sinara-hw/Stabilizer_Piezo_Driver/README.md

# Stabilizer_Piezo_Driver
Simple piezo driver mezzanine for Stabilizer

## Design Files

Design files (schematics, PCB layouts, BOMs) can be found at [Stabilizer_Piezo_Driver/Releases](https://github.com/sinara-hw/Stabilizer_Piezo_Driver/releases).

## Wiki

More information can be found on the [wiki](https://github.com/sinara-hw/Stabilizer_Piezo_Driver/wiki).
