sinara-hw/Stabilizer_Piezo_Driver/(list of files, drawings)

Other design files:
pcb/HV_DRV_ADHV4702.SchDoc
pcb/HV_DRV_PA15FLA.SchDoc
pcb/mechanics.SchDoc
pcb/Offset_Selector.SchDoc
pcb/overtemp_indicator.SchDoc
pcb/power_supplies.SchDoc
pcb/Stabilizer_Piezo_Driver.PrjPCB
pcb/Stabilizer_Piezo_Driver.SchDoc
