sinara-hw/Stabilizer_Piezo_Driver/(threads)

Thread 1 (2019-05-16):

[RFC] New daughterboard: Piezo Driver

dtcallcock, 2019-05-16:
I am thinking that many Stabilizers will end up servoeing on piezos (doubling cavities, laser cavities, mirror adjusters etc.).  Therefore does it make sense to have a dedicated daughterboard for this?

Obviously [Zapper](https://github.com/sinara-hw/zapper/issues/1) is under development but may end up being overkill for this application.  I'm imagining a very simple board with a DC-DC module, a couple of HV opamps and a few DIP switches to set ranges.

Closed 2019-12-01.

Thread 2 (2019-09-07):

ADHV4702

dtcallcock, 2019-09-07:
I may need to get something working before this board is ready so I'm planning on ordering an [eval board](https://www.analog.com/media/en/technical-documentation/user-guides/EVAL-ADHV4702-1CPZ-UG-1444.pdf) for the new [ADHV4702](https://www.analog.com/media/en/technical-documentation/data-sheets/ADHV4702-1.pdf).

If that works out I'll let you know.  Perhaps we could just copy this design (and make it 2-ch) if it does.

gkasprow, 2019-12-01:
@dtcallcock any opinion here?
I'd like to finish the design. Anyway, I implemented bot ADHV4702 + my discrete driver.

hartytp, 2019-12-01:
Cool. Do you have a schematic preview? I won't have time to do a design review, but I'm just curious...

gkasprow, 2019-12-01:
@hartytp  Here are very initial, not finished schematics
[stabilizer_current_sense.PDF](https://github.com/sinara-hw/Stabilizer_Piezo_Driver/files/3908742/stabilizer_current_sense.PDF)

dtcallcock, 2020-01-05:
> I implemented bot ADHV4702 + my discrete driver.

What do you think your driver will offer over the ADHV4702?

Will the two options be population options or will there be a switch or jumper?

dtcallcock, 2020-01-05:
Is it worth running anything to the GPIO header?  Perhaps just the status LEDs so that Stabilizer can throw an error if the amp shuts down?

gkasprow, 2020-01-05:
I implemented this discrete driver mainly for fun. We will probably leave only ADHV chip.
My driver can easily go +/- 60V into the 1nF load at 1MHz and can be easily scaled by changing the MOSFETs. Driver can be selected by the jumpers.

Thread 3 (2019-09-07):

Form Factor

dtcallcock, 2019-09-07:
Whilst a stabilizer AFE would be the most convenient in some circumstances it would preclude use with [Pounder](https://github.com/sinara-hw/Pounder/issues) or [Driver](https://github.com/sinara-hw/meta/issues/37) if they end up being Stabilizer AFEs.

How about just making it a standalone board with 2x input/output on the FP and barrel connectors for power?

We could make the board-board connectors a population option to retain AFE capability.

hartytp, 2019-09-07:
How would you configure it?

hartytp, 2019-09-07:
Or, is this just a 2 channel, fixed-gain (DIP switches?) HV amp?

dtcallcock, 2019-09-07:
Yeah, this board would be super-simple.  If you want bells and whistles there will be Zapper at some point.

DIP switches to select between a few different ranges and gains would be useful if easy to implement.

hartytp, 2019-09-07:
What use cases are you thinking of for this, and where would the D/A be?

dtcallcock, 2019-09-07:
> What use cases are you thinking of for this

My idea is to have the simplest possible board that would allow Stabilizer to drive piezos.  The only reason not to make it specifically a Stabilizer AFE is that it would block you from using other AFEs.

> , and where would the D/A be?

This would just be a completely analog voltage amplifier.

hartytp, 2019-09-07:
> This would just be a completely analog voltage amplifier.

I meant what would drive it, but you answered that anyway.

> My idea is to have the simplest possible board that would allow Stabilizer to drive piezos. The only reason not to make it specifically a Stabilizer AFE is that it would block you from using other AFEs.

hmmm. Are you saying that you would use the same Stabilizer card to drive Zapper that you also use with another AFE?

dtcallcock, 2019-09-07:
> hmmm. Are you saying that you would use the same Stabilizer card to drive Zapper that you also use with another AFE?

Yes.  For example, for a doubling cavity lock (or locking a fiber laser to an iodine reference cell) you would have a PDH AFE on Stabilizer and then this piezo driver board between Stabilizer and the cavity piezo.

> drive Zapper

This isn't [Zapper](https://github.com/sinara-hw/zapper/issues/1).  Right now Zapper looks like it will be [way overspecced](https://github.com/sinara-hw/zapper/issues/1#issuecomment-497932589) for this common use case.  Obviously the Zapper spec is not set in stone yet though.

Perhaps the name of this repository should be changed to 'Stabilizer piezo driver' or something.

hartytp, 2019-09-07:
> Yes. For example, for a doubling cavity lock (or locking a fiber laser to an iodine reference cell) you would have a PDH AFE on Stabilizer and then this piezo driver board between Stabilizer and the cavity piezo.

Okay, makes sense. So this allows you to cover that case with only a single stabilizer. Fair enough.

gkasprow, 2019-09-20:
Let's draft specification:
- 3U form factor with panel, board size identical to current sense mezzanine.
- 2 HV channels
- ADHV4702 + my [discrete component driver](https://github.com/sinara-hw/Stabilizer_Piezo_Driver/issues/1#issuecomment-505290412) + DIP switch for configurable gain. This would let us test things for Zapper.
- 2x SMA input (maybe MCX?)
- 2x SMA output
- DC jack + 4 pin Molex supply connector on the back
- optional pin header for direct attach to the Stabilizer as a mezzanine
- 2x DC/DC converter [ R12-100B](https://www.digikey.com/en/datasheets/recom-power/recom-power-rxx-b) which can be adjusted +50...+135. We can make it adjustable by DIPswitches and simple protection circuit which makes sure we never exceed ADHV4702 safe operation range of 220V. Do we need to support asymetrical operation?

gkasprow, 2019-09-20:
do we plan to add some current limit protection for the ADHV4702 ?
It has internal temperature sensor. It could be used to disable power and turn on big, red LED on the front panel. The chip has also temperature protection that needs to be enabled.

dtcallcock, 2019-09-20:
> 2x SMA input (maybe MCX?)

Probably makes sense to use SMA so that a short SMA jumper can be used.

> 2x SMA output

Often slightly less common connectors are used on HV supplies to prevent accidentaly connecting the wrong thing and destroying it. I have seen SMB, SMC, LEMO OO and LEMO 0B used.

> DC jack + 4 pin Molex supply connector on the back

The DC jack would be on the front?  If so, would you be able to use a short barrel-barrel cable to power it from a Stabilizer running on POE?

> DC/DC converter R12-100B which can be adjusted +50...+135

150 and 200V piezos are also out there.  I think +135V is close enough to 150V and 200V piezos are uncommon enough that this is acceptable.  However if there is a different DC/DC that will do 50-150V  or 50-200V that would be better.

Otherwise looks great.

dtcallcock, 2019-09-20:
> do we plan to add some current limit protection for the ADHV4702 ?
It has internal temperature sensor. It could be used to disable power and turn on big, red LED on the front panel.

That seems to be how the datasheet is recommending you implement short circuit protection.  Sounds reasonable to me.

gkasprow, 2019-09-20:
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

LEMOs are expensive. They are woth their price, but still. SMB/SMC is fine

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

Yes, but there is also 12V on the mezzanine connector

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

Thre is compatible R12-150B that goes +92...+200.
So, the question is if we should make it to support asymmetrical operation.
For example, the user can select let's say +150, -50V. Then shall we add some adjustable offset to the input or simply sacrify the DAC resolution ?
>
> Otherwise looks great.

gkasprow, 2019-09-20:
The evaluation kit of [ADHV ](https://www.analog.com/media/en/technical-documentation/user-guides/EVAL-ADHV4702-1CPZ-UG-1444.pdf)chip has on-board DC/DC converter based on [LT8304 ](https://www.analog.com/media/en/technical-documentation/data-sheets/8304fa.pdf). We can copy the design and make it operational over wider voltage range than R12-xxxB modules.

gkasprow, 2019-09-20:
Such solution can generate symetrical outputs. But I'm not sure if it is worth the effort.  The Recom modules are not that expensive (38EUR/pc)

dtcallcock, 2019-09-23:
>So, the question is if we should make it to support asymmetrical operation.

I've never had a need for piezo drivers that goes negative.

hartytp, 2020-01-08:
Was a decision made on the form-factor for this? IIRC it was decided (and I think it's a good idea) to make this a stand-alone card with a FP power connector, rather than a stabilizer mezzanine. Is that correct/still the case?

If so, this project should have a name change really. Also, what's the differentiation between this and the Zapper proposal? Just that Zapper is bipolar? Or, should they be merged?

hartytp, 2020-01-08:
@dtcallcock out of curiosity, what are your plans for using this for OSAs? What will you do for the transimpedance front-end for the PD? Will you design a small PCB to go right by the cavity? If so, how do you plan to power it? Use an external supply or break out the Stabilizer supplies somehow? Just curious...

gkasprow, 2020-01-08:
This module can either work as a Stabilizer mezzanine or stand-alone 2-channel amplifier.
This design is a 2-channel amplifier while Zapper will be multi-channel EEM.

hartytp, 2020-01-08:
> This module can either work as a Stabilizer mezzanine or stand-alone 2-channel amplifier.

Okay, nice :)

> This design is a 2-channel amplifier while Zapper will be multi-channel EEM.

I see. How many channels will Zapper have?

hartytp, 2020-01-08:
Answering my own question: [8](https://github.com/sinara-hw/zapper/issues/1)

How realistic is that from a power/component density point of view.

Anyway, I guess that there are enough differences between the two designs that it doesn't make sense to try to unify them.

gkasprow, 2020-01-08:
I treat the Piezo Driver as a prototype of Zapper. We will test PSU, 2 amplifier conceptions, protections.
If we go for ADHV4702, we can have even 32 channels. Some limitation is the output connector which needs to work with HV. There are [industrial rectangular connectors](https://www.tme.eu/html/EN/hi-temp-connector-inserts-180-degc/ramka_13219_EN_pelny.html) that can handle such voltage.

dnadlinger, 2020-01-08:
Not wanting to derail this discussion here, but for open-loop applications, charge-based drive might also be interesting to improve linearity/reduce hysteresis. (One use in AMO labs would be e.g. for multi-axis positioners/mirror mounts, although predictable response matters less there than for microscopy or trying to make absolute changes to lens positions in an imaging system.)

dtcallcock, 2020-01-08:
> @dtcallcock out of curiosity, what are your plans for using this for OSAs? What will you do for the transimpedance front-end for the PD? Will you design a small PCB to go right by the cavity?

Yes.  Perhaps Nadlinger's board.  Perhaps just an eval board.

> If so, how do you plan to power it? Use an external supply or break out the Stabilizer supplies somehow?

There was talk of putting some kind of power connectors (eg. M8-3) on here (or Stabilizer/Pounder), but there doesn't seem to be the front panel space for it.  For now I'll probably go with a bench PSU.  I have been thinking it might be worth developing a Eurocard PSU for Sinara though.

> I guess that there are enough differences between the two designs

There was an idea that Zapper would have onboard DACs and and EEM interface too.  Obviously the spec is still up for grabs.

> If we go for ADHV4702

A range of >200V was envisaged but if the ADHV4702 works great we should revisit that requirement.

gkasprow, 2020-01-08:
Btw, the 3U PSU is under development. One can see some drawings [here](https://viewer.autodesk.com/id/dXJuOmFkc2sub2JqZWN0czpvcy5vYmplY3Q6YTM2MHZpZXdlci90NjM3MTMyMTY5NDI3NjA3MzM4X2E5YjQzMDEzLTg4ZWQtNGVhZC05ZTM4LWUzODFlNzcyYWUyNy5jb2xsYW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)
It is cooperation with CERN, we develop a low-cost alternative to COTS solutions.
One is 230V, 400W
Another is 18-72V, 200 or 400W. They fully conform with CPCIS including ORing and current sharing. The AC version has an IEC connector on the front panel. It also supports power delivery via a backplane connector. There is an option to produce it without any active circuits, just 12V.
We can make a version with just DC jacks on the front panel and Molex connectors on the back panel if there is enough interest.

dnadlinger, 2020-01-08:
> If so, how do you plan to power it? Use an external supply or break out the Stabilizer supplies somehow?

One option would be to settle on a common "sensor" connector for the ecosystem (e.g. photodiodes, external preamps, …). We could just use a 4-pin LEMO connector and two twisted pairs (+12/power ground, signal/signal ground) if we are careful with conducted EMI from the DC/DC converters we'd invariably need on the peripherals.

gkasprow, 2020-01-08:
About the standardized connectors, LEMOs are great but expensive. Would 4 pins be sufficient? What about M8? They are low cost, robust and support up to 8 pins.

gkasprow, 2020-01-08:
@dnadlinger Do you mean HV amplifier with the current output? Let's start a discussion about it in /meta

hartytp, 2020-01-08:
https://www.piezodrive.com/wp-content/uploads/2016/01/IntroToCharge.pdf

gkasprow, 2020-01-08:
We could try to implement it as a feature of the Piezo Driver, but we would need other connectors. Moreover, I think such a driver needs to be matched with piezo to maintain stability.

hartytp, 2020-01-08:
> There was an idea that Zapper would have onboard DACs and and EEM interface too. Obviously the spec is still up for grabs.

If the DACs were really the only difference I'd have thought it would make sense to unify the design. The cost of adding a couple of SPI DACs and an EEM connector to this design is basically nill.

However, it sounds like there are more differences than that, so the designs should remain separate. I don't feel strongly either way, just interested to understand the design goals.

hartytp, 2020-01-08:
> One option would be to settle on a common "sensor" connector for the ecosystem (e.g. photodiodes, external preamps, …). We could just use a 4-pin LEMO connector and two twisted pairs (+12/power ground, signal/signal ground) if we are careful with conducted EMI from the DC/DC converters we'd invariably need on the peripherals.

:+1:

Thread 4 (2019-12-01):

Power supply

gkasprow, 2019-12-01:
I plan to make the design quite universal. What about using 2 power supplies, each delivering 50..135V or 92..200V depending on assembly variant.
Then the user can choose the voltage range, both positive and negative by toggling the two rotary switches. One of 4 values would be possible within tuning range of each power supply.
In this way, any combination of upper and lower rails would be possible
So one can have for example
- 0-200 (one DC/DC module only)
-50..+50
-100..+100
-200..0 (one DC/DC module only)
-75..+75, etc.
-50...+150
There is simple protection circuit that checks if the Vpos - Vmin <200V. If it's true then power is disabled and an alarm LED is lit.
The rail voltages are signalized using 8 LEDs on the front panel.
In addition, an offset can be added to the input amplifier to use the DAC range fully. 16-position hex rotary swich would do the job.
Maybe one DIP switch to choose the gain.
In this way, we can satisfy most use cases by just adding a few resistors and 3 switches.
The module can operate stand-alone supplied from a single 12V DC jack or 4 pins Molex connector.
It can be also supplied from Stabilizer where DAC outputs are routed to the inputs.

gkasprow, 2019-12-01:
Edit: to simplify the design, the switches can be placed on the panel. No LEDs are needed.
The only LEDs woult be PowerOK and Overvoltage alert
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

dtcallcock, 2020-01-05:
> 50..135V or 92..200V depending on assembly variant

How about using something that can do 0-200V to avoid having variants:

https://www.xppower.com/portals/0/pdfs/SF_C_Series.pdf
https://www.xppower.com/portals/0/pdfs/SF_CA_Series.pdf

These are ~$150 compared to the ~$50 of the Recom module but if there is only one (see below) and population options are avoided, then that seems reasonable.  They look like they are lower EMI/ripple too.

> both positive and negative

I'd be happy to drop the negative voltages.  This simplifies the design as the offset is fixed and the gain and output voltage can just be controlled by the same single dial.  The overvoltage detection circuit can also be omitted.

Does anyone have a use case for negative voltages?

jbqubit, 2020-01-06:
Piezo response becomes highly nonlinear < -20  V. There's no practical application I can see for a negative rail below -20 V. See Newport [tech note](https://www.newport.com/medias/sys_master/images/images/hf1/hc8/9046758588446/Tech-Note-Piezo-Theory-Physics-and-Design.pdf).

dtcallcock, 2020-01-06:
>There's no practical application

There are exotic piezo stacks like [tube scanners](https://www.piezodrive.com/actuators/piezoelectric-tube-scanners/) that require symmetric +/-V.  I've never seen one used in an AMO lab and given the number of commercial solutions out there I think the emphasis for this board should be simplicity rather than covering all possible uses.

>negative rail below -20 V

I note that some commercial piezo drivers go slightly (eg. 10-20V) negative, but most do not.  I don't think this is a feature worth increasing circuit complexity for (or necessarily even desirable).

jbqubit, 2020-01-06:
Suppose a piezo with 100 V max rating. I can think of two aspects in favor of -20V. 1) 20% increase in travel 2) 20% lower peak voltage for a given travel (lower stress may increase piezo lifetime). I've certainly encountered circumstances where that 20% increase in scan range made my life much easier.

I don't feel strongly about it.

gkasprow, 2020-01-06:
The amplifier is not rail-to-rail type. It needs a certain negative supply to support operation from 0.

dtcallcock, 2020-01-07:
The ADHV4702 can get within 1.5V of the rail.  Can we run V_EE off the planned -5V rail?

gkasprow, 2020-01-07:
Yes, we can and we should.

JakubKajzer, 2020-08-03:
Hello
I have a few questions about the power supply:
1. Should we keep 50..135V/92..200V  high voltage supply variants or "using something that can do 0-200V to avoid having variants"?
2. Just to be sure, only negative voltage we need is -5V?

Thread 5 (2020-11-06):

schematic review

gkasprow, 2020-11-06:
@JakubKajzer
- the amplifier gain depends on the source output impedance. did you take it into account?
- connecting outputs of two amplifiers is not a good idea.
- did you simulate the signal chain with offsets?
- if you need components that are missing in the libs, let me know
- why R21 is 47Ohm?
- it would be good to add some signalization of overtemperature. Are you sure that the connection between TMP and SD is a good idea?
- the idea behind the latch-up circuit was to protect the amplifier before too high a voltage, not temperature.
- what is the role of IC10?
- do you think the 5V rail has low noise and stability so can be injected to the OFFSET input?
- will OPA197 work with output close to rails under the load?

JakubKajzer, 2020-11-27:
>the amplifier gain depends on the source output impedance. did you take it into account?

Yes, I simulated an amplifier with various capacitance at output. At lower gain, this problem is more visible, but due to significant series resistance at the output, the max gain peak is about 3dB at about 300kHz

>connecting outputs of two amplifiers is not a good idea.

Sorry for that, my mistake. It is a good idea, to make an optomos switch at outputs instead of switching inputs?

>did you simulate the signal chain with offsets?

Yes, offset is amplified with the same gain as an input signal.
In a discrete driver, the gain is 100x, so the offset can easily saturate the driver. Should I lower the gain?

>why R21 is 47Ohm?

I don't know what capacitances will be driven, so I decided to choose 47Ohm. This value should be less when driving bigger capacitances and should be higher when driving smaller capacitances (according to a datasheet of ADHV4702-1).

>it would be good to add some signalization of overtemperature. Are you sure that the connection between TMP and SD is a good idea?

A red led on the front panel will be enough? Connecting TMP and SD together, according to the datasheet, provides overtemperature protection.

>the idea behind the latch-up circuit was to protect the amplifier before too high a voltage, not temperature.

I added overtemperature protection because there wasn't any for the discrete driver. Should I add overvoltage protection?

>what is the role of IC10?

I added IC10 to negate LM75 outputs, so LM75 could work without changing its internal registers.

>do you think the 5V rail has low noise and stability so can be injected to the OFFSET input

Now I see that I should add a pi filter to offsets supply.

>will OPA197 work with output close to rails under the load?

OPA197 can provide about 2mA at the output with a 0.1V swing from the power supply.

gkasprow, 2020-12-16:
> >the amplifier gain depends on the source output impedance. did you take it into account?
>
> Yes, I simulated an amplifier with various capacitance at output. At lower gain, this problem is more visible, but due to significant series resistance at the output, the max gain peak is about 3dB at about 300kHz

I meant SOURCE impedance, not the impedance of the amplifier

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

you need to switch both.
Just use DIP switches to choose which one is connected to input and output. Make sure both cannot be selected

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

yes, use full DAC range

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

OK, make it big, 0805 or so

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

OK, use red LED.

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

If there is a risk that the user can setup dangerous voltage for driver IC, add such protection.

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

since we don't need such circuit for temperature protection, skip it.

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

please add low noise LDO

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

OK
>
>
>

JakubKajzer, 2021-01-01:
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

I checked this at simulation and due to low input impedance, at input must be placed a voltage follower like in discrete amplifier.

gkasprow, 2021-01-13:
sure, you can increase the supply to +/-12V. It is already available from Stabilizer.
Yes, change the MOSFET, but use one with similar specs as the low-side one.

JakubKajzer, 2021-01-20:
I've uploaded updated schematics.

dtcallcock, 2021-03-05:
@JakubKajzer Can you post a pdf please?

JakubKajzer, 2021-03-06:
@dtcallcock
Of course
[schematic.PDF](https://github.com/sinara-hw/Stabilizer_Piezo_Driver/files/6096184/schematic.PDF)

Thread 6 (2021-08-05):

Nitpick: AD8541 used as overtemperature comparators

dnadlinger, 2021-08-05:
Just scrolled through the release PDF out of curiosity, and noticed that 2xAD8541 are used as comparators/LED drivers for the overtemperature circuit. Since those aren't appear anywhere else on the BOM, isn't that a bit of overkill, i.e. wouldn't pretty much any cheap dual comparator for 1/10th the price also do the trick?

gkasprow, 2021-08-05:
I wrote the same in of of my reviews

JakubKajzer, 2021-08-09:
AD8541 changed to LM358

Closed 2021-08-12.

Thread 7 (2021-09-16):

Testing v1.0.2

JakubKajzer, 2021-09-16:
When starting the board, it turned out that the converter could not be set to a voltage higher than 160V. This was due to the opening of the transistors in the voltage control system of the converter during shorting the V<sub>ADJ</sub> and V<sub>REF</sub> pin.
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
This could be changed to R2R DAC controlled by a switch like in voltage offset selector.

JakubKajzer, 2021-09-16:
The next problem is with the overtemperature indicator. The LM358 can't rail-to-rail and due to this, the upper voltage is only 1.26V. It can be changed to LMV358 (pin to pin compatible).

JakubKajzer, 2021-09-16:
The offset voltage selector works well, but it gives max value when you choose "0" on the hexadecimal switch and min value when choosing "F". This is quite unintuitive.

JakubKajzer, 2021-09-16:
I noticed, that the device draws around 1A from 12V supply during startup. Maybe a slow start circuit should be added.
