sinara-hw/Stabilizer_Piezo_Driver/(commit log)

2020-07-20 initial sch
    [HV_DRV.SchDoc, HV_DRV_Discrete.SchDoc, Stabilizer_Piezo_Driver.PrjPCB, Stabilizer_Piezo_Driver.SchDoc, mechanics.SchDoc, power_supplies.SchDoc]
2021-01-20 0.9.1
    First review updates
    [HV_DRV.SchDoc, HV_DRV_Discrete.SchDoc, Output_Switch.SchDoc, Stabilizer_Piezo_Driver.PrjPCB, Stabilizer_Piezo_Driver.SchDoc, overtemp_indicator.SchDoc, power_supplies.SchDoc]
2021-08-03 update template; added panel 3D file
    [Bill of Materials-Stabilizer_Piezo_Driver(default).xlsx, HV_DRV_ADHV4702.SchDoc, HV_DRV_PA15FLA.SchDoc, Offset_Selector.SchDoc, Output_Switch.SchDoc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]
2021-08-04 panel 3D model edited; minor fixes
    [HV_DRV_ADHV4702.SchDoc, HV_DRV_PA15FLA.SchDoc, Offset_Selector.SchDoc, Stabilizer_Piezo_Driver.PrjPCB, Stabilizer_Piezo_Driver.SchDoc, mechanics.SchDoc, overtemp_indicator.SchDoc, panel.SLDPRT]
2021-08-05 minor fix
    [HV_DRV_ADHV4702.SchDoc, HV_DRV_PA15FLA.SchDoc, Offset_Selector.SchDoc, Stabilizer_Piezo_Driver.PrjPCB, Stabilizer_Piezo_Driver.SchDoc, mechanics.SchDoc, overtemp_indicator.SchDoc, power_supplies.SchDoc]
2021-08-08 changed HV cap; cheaper comparators
    [Stabilizer_Piezo_Driver.PrjPCB, overtemp_indicator.SchDoc, power_supplies.SchDoc]
2021-08-09 another HV cap change
    [HV_DRV_ADHV4702.SchDoc, Stabilizer_Piezo_Driver.PrjPCB]
2021-08-10 changed switches
    [HV_DRV_ADHV4702.SchDoc, HV_DRV_PA15FLA.SchDoc]
